opensourcebeehives/DataLogger/(commit log)

2016-10-24 Change Arduino to switch off LEDs after video, only wait 6 loops before sleep
2016-10-24 Fix licensing on Arduino
    [SleepyPi_FW.ino]
2016-10-25 Explicitly mount USB stick, add comments
2016-10-27 Add pictures for assembly instructions
2017-05-16 remove video voltages and timers
2017-05-17 Add battery check, main loop as function
2017-07-08 Add button code, works for turning off but not turning on, try detaching interrupt
2017-07-10 Revert "Add button code, works for turning off but not turning on, try detaching interrupt"
    This reverts commit 7dc8d5a57883ea2e19fca0eaa89249b06759545a.
    [SleepyPi_FW.ino]
2017-07-10 Change battery voltage to prepare for SLA low voltage cutoff
